David-LETINAUD/LORA_RASPI_ATMEGA/(commit log)

2019-06-04 Python_Save_database
    Gère connexion série avec module réception ARDUINO LORA
    Extraction de l'adresse du capteur, de la température et de l'humidité des trames
    Sauvegarde des données dans une base de donnée mysql avec la date
    [config.cfg]
2019-06-04 Arduino_LORA_client envoie trame
    Mesure du niveau de batterie
2019-06-05 Gestion de l'envoie de trames
2019-06-05 Demande d'acquittement et renvoie de trames
2019-06-05 Gestion de l'envoie de trames par le serveur
2019-06-11 Acquisition Temp/Hum en low power
2019-06-12 Ajout localisation des capteurs pour l'interface + calcul température ressentie
    [config.cfg]
2019-06-13 Amélioration de la modularité
2019-06-17 Ultra basse consommation
    Implémentation du circuit tpl5110
2019-06-24 Implémentation insert distant sur microsoft SQL server
    [config.cfg]
2019-06-28 ADC correction
2019-06-28 Retour sur mysql
    [config.cfg]
2019-07-09 Augmentation de la robustesse
    Evite l'ajout d'un double d'une acquisition dans le cas ou l'infos transmise par le capteur est bien recu mais l'acquittement n'est pas reçu par le capteur
2019-07-12 Nouveau recepteur
    [config.cfg]
2019-07-12 ACK_OPTION pour la redondance du serveur
2019-07-12 import thread modif pour compatibilité python 2.7 et 3
2019-07-22 ADC optimisé
2019-07-23 Arduino LORA connection
2019-07-23 Arduino lora connection update
2019-07-23 Arduino lora pcb connexion
2019-07-23 temp hum PCB
2019-07-23 Connexions et PCB README
